flavian112/croc/doc/fftodile_routed.jpg

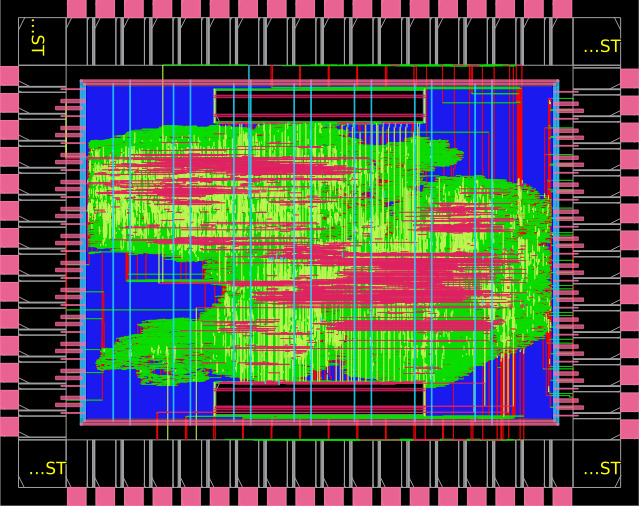
doc/fftodile_routed.jpg
